Quantum-Science-and-Technology-Lab/carrier_PCB/README.md

# Carrier PCB

A 48 DC line, 8 RF line chip carrier PCB designed for facilitating experiments at cryogenic temperatures.

Screenshot 2025-01-05 at 11 27 40 AM

# License

This project is licensed under the CERN Open Hardware Licence Version 2 — Weakly Reciprocal (CERN-OHL-W). For details please see the LICENSE file or https:/cern.ch/cern-ohl.
SPDX-License-Identifier: CERN-OHL-W-2.0
https://spdx.org/licenses/CERN-OHL-W-2.0.html
