Quantum-Science-and-Technology-Lab/carrier_PCB/net_inspector_report.csv

Net Code | Net Name | Pad Count | Via Count | Via Length (mm) | Track Length (mm) | Die Length (mm) | Net Length (mm) | F.Cu (mm) | In1.Cu (mm) | In2.Cu (mm) | B.Cu (mm)
001 | Net-(R1-Pad1) | 2 | 2 | 3.0900 | 29.9254 | 0.0000 | 33.0154 | 8.0992 | 0.0000 | 0.0000 | 21.8263
002 | Net-(R7-Pad1) | 1 | 2 | 0.2700 | 55.9505 | 0.0000 | 56.2205 | 53.7517 | 2.1989 | 0.0000 | 0.0000
003 | Net-(Sample1-Pad3) | 2 | 2 | 0.2700 | 34.7609 | 0.0000 | 35.0309 | 6.2109 | 28.5500 | 0.0000 | 0.0000
004 | Net-(Sample1-Pad4) | 2 | 2 | 0.2700 | 31.5100 | 0.0000 | 31.7800 | 2.9601 | 28.5500 | 0.0000 | 0.0000
005 | Net-(Sample1-Pad5) | 2 | 2 | 0.2700 | 34.3573 | 0.0000 | 34.6273 | 2.4843 | 31.8730 | 0.0000 | 0.0000
006 | Net-(Sample1-Pad6) | 2 | 2 | 0.2700 | 31.0746 | 0.0000 | 31.3446 | 2.5246 | 28.5500 | 0.0000 | 0.0000
007 | Net-(Sample1-Pad7) | 2 | 2 | 0.2700 | 34.4057 | 0.0000 | 34.6757 | 2.3223 | 32.0834 | 0.0000 | 0.0000
008 | Net-(Sample1-Pad8) | 2 | 2 | 0.2700 | 31.3036 | 0.0000 | 31.5736 | 2.7536 | 28.5500 | 0.0000 | 0.0000
009 | Net-(Sample1-Pad9) | 2 | 2 | 0.2700 | 34.5863 | 0.0000 | 34.8563 | 2.2714 | 32.3149 | 0.0000 | 0.0000
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
