Quantum-Science-and-Technology-Lab/carrier_PCB/schematic.png

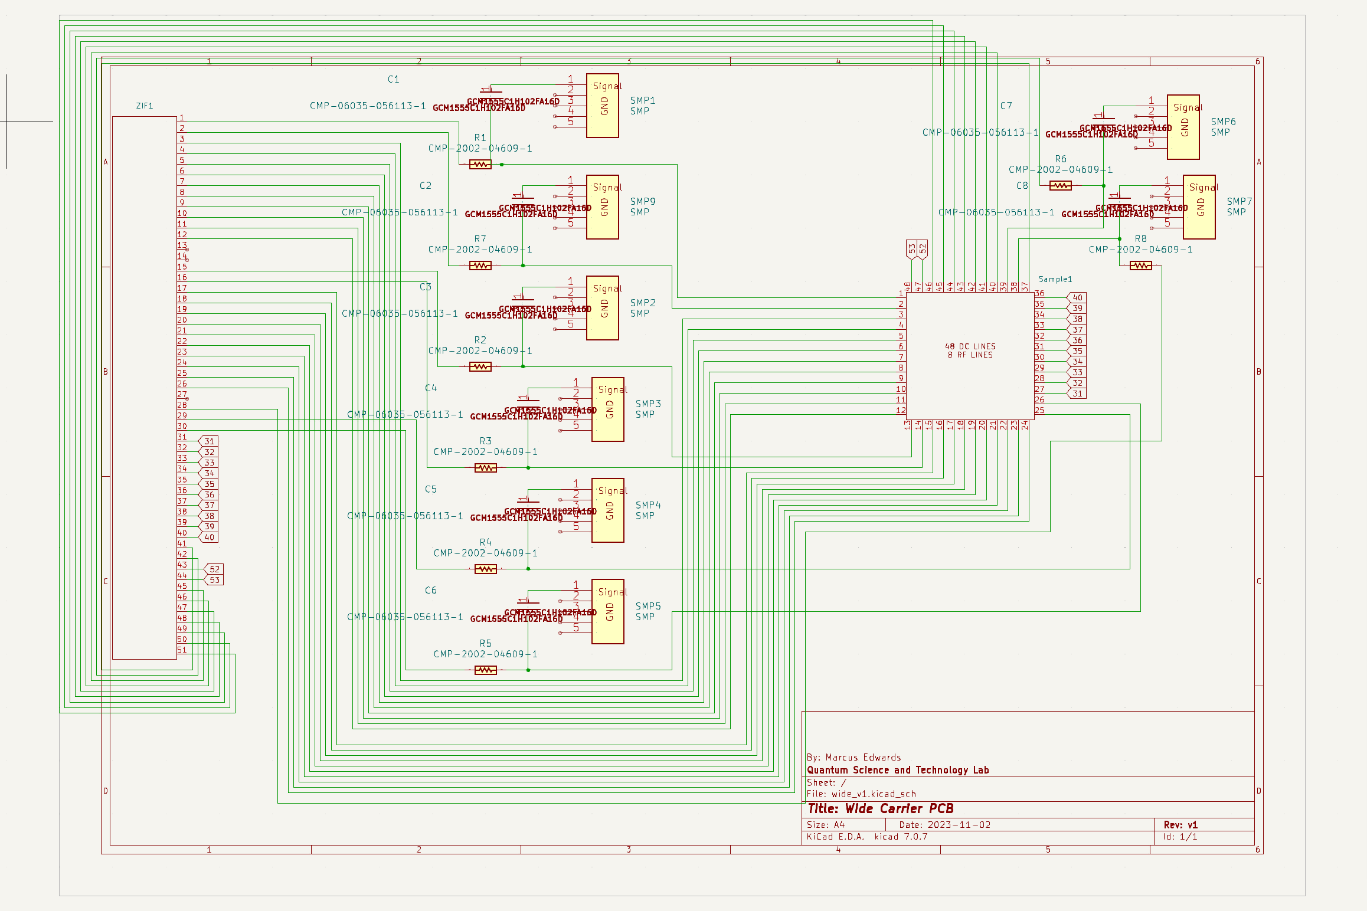
schematic.png
