Quantum-Science-and-Technology-Lab/carrier_PCB/characteristic_impedance.png

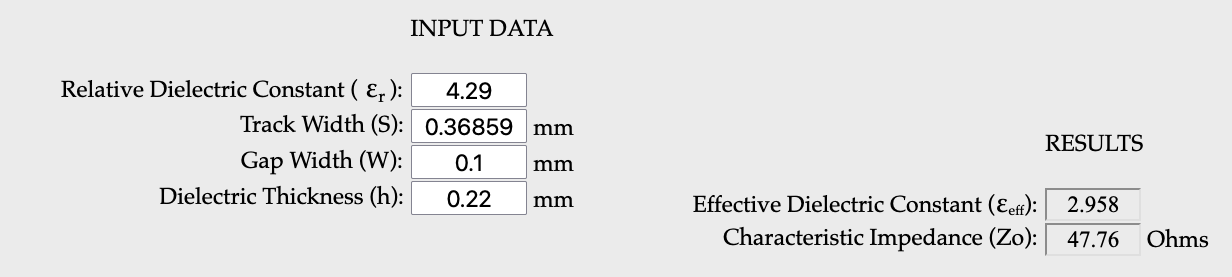
characteristic_impedance.png
