Quantum-Science-and-Technology-Lab/carrier_PCB/(commit log)

2024-05-09 Init commit
    [net_inspector_report.csv, wide_v1_4_layer.kicad_pcb]
2024-05-09 Add schematic
2024-05-10 Route around second large hole
    [wide_v1_4_layer.kicad_pcb]
2024-05-11 Fix filled zone boundaries
    [wide_v1_4_layer.kicad_pcb]
2024-05-15 Adjust stackup to PCBgogo specs
    [wide_v1_4_layer.kicad_pcb]
2024-05-28 Generate .drl files
    [wide_v1_4_layer.kicad_pcb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]
2024-07-09 Add netlist and schematic
    [wide_v1.kicad_sch, wide_v1_4_layer.kicad_pcb]
2024-07-10 Export footprints
2025-01-05 Upload schematic file
